tuanthanhhh/project233/image/Pulse-Oximeter-Sensor-Working-450x359.jpg

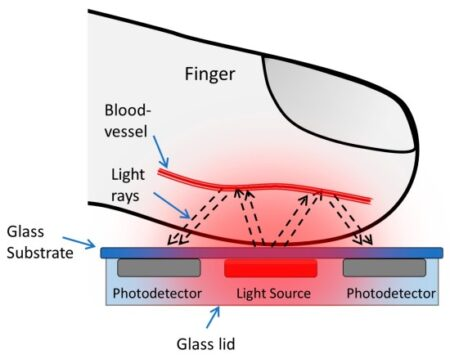
image/Pulse-Oximeter-Sensor-Working-450x359.jpg
