tuanthanhhh/project233/image/Khối chính trong hệ thống.png

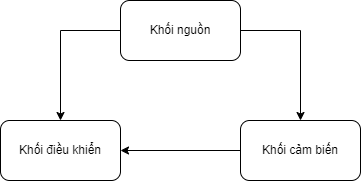
image/Khối chính trong hệ thống.png
