tuanthanhhh/project233/image/QR_github.png

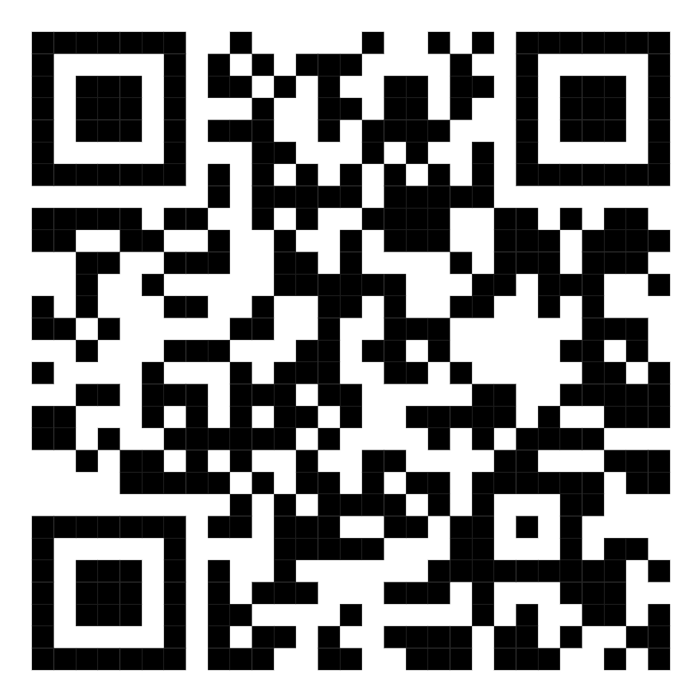
image/QR_github.png
