tuanthanhhh/project233/PCB/3D_Lib/1042.STEP

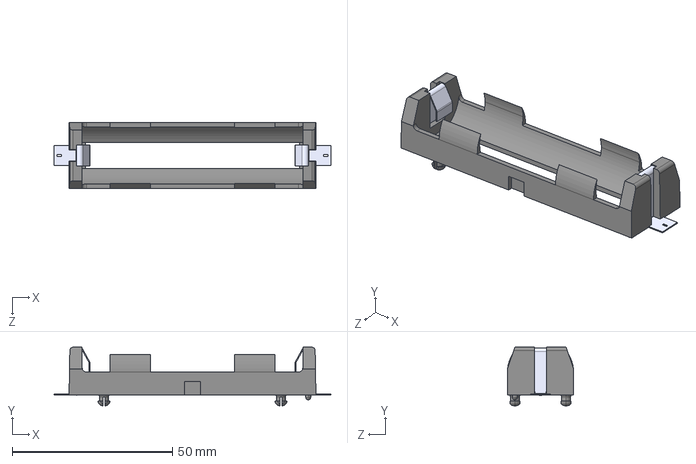
[picture p64: CAD file, 2024-06-25]
PCB/3D_Lib/1042.STEP
86.5 x 18.3 x 20.7 mm
