tuanthanhhh/project233/PCB/3D_Lib/inductor.STEP

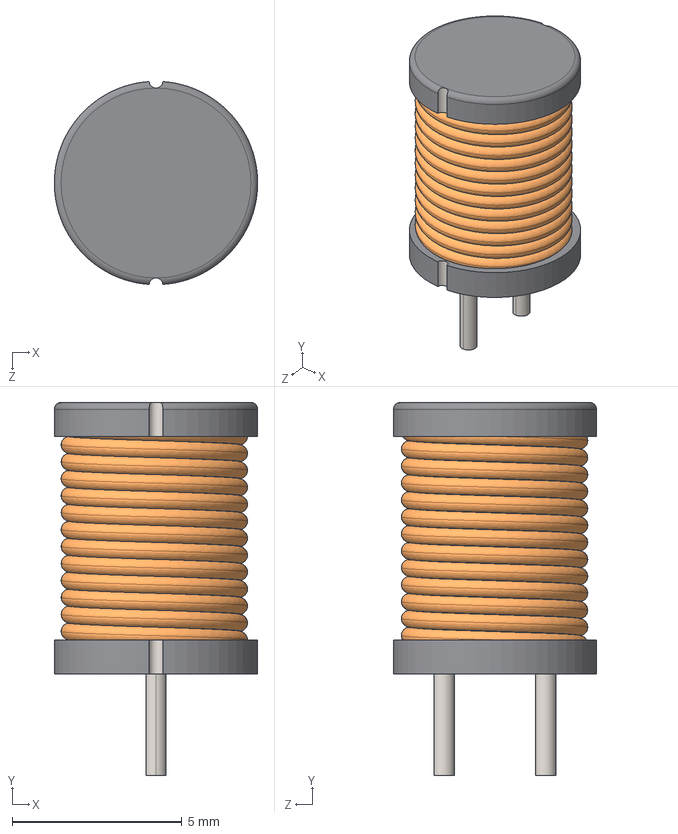
[picture p65: CAD file, 2024-06-06]
PCB/3D_Lib/inductor.STEP
6.00 x 11.0 x 5.99 mm
