tuanthanhhh/project233/PCB/3D_Lib/18650 Full.STEP

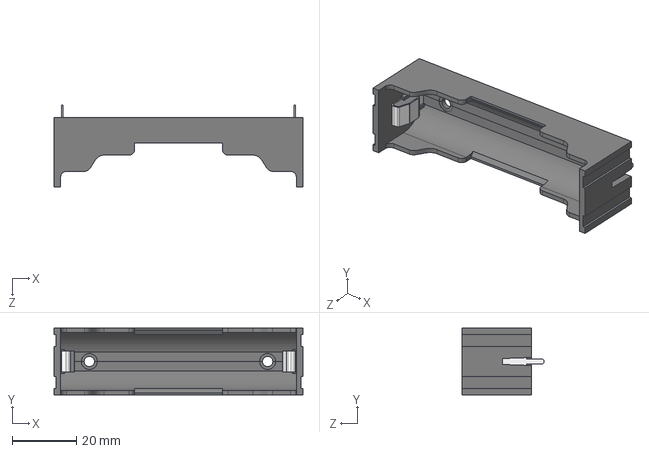
[picture p66: CAD file, 2024-06-25]
PCB/3D_Lib/18650 Full.STEP
77.6 x 20.8 x 25.5 mm
18650m_1
18650s_По умолчанию x 2
