tuanthanhhh/project233/PCB/docs schematic/STM32F1-STM32F103C8T6-Blue-Pill-schematics.pdf

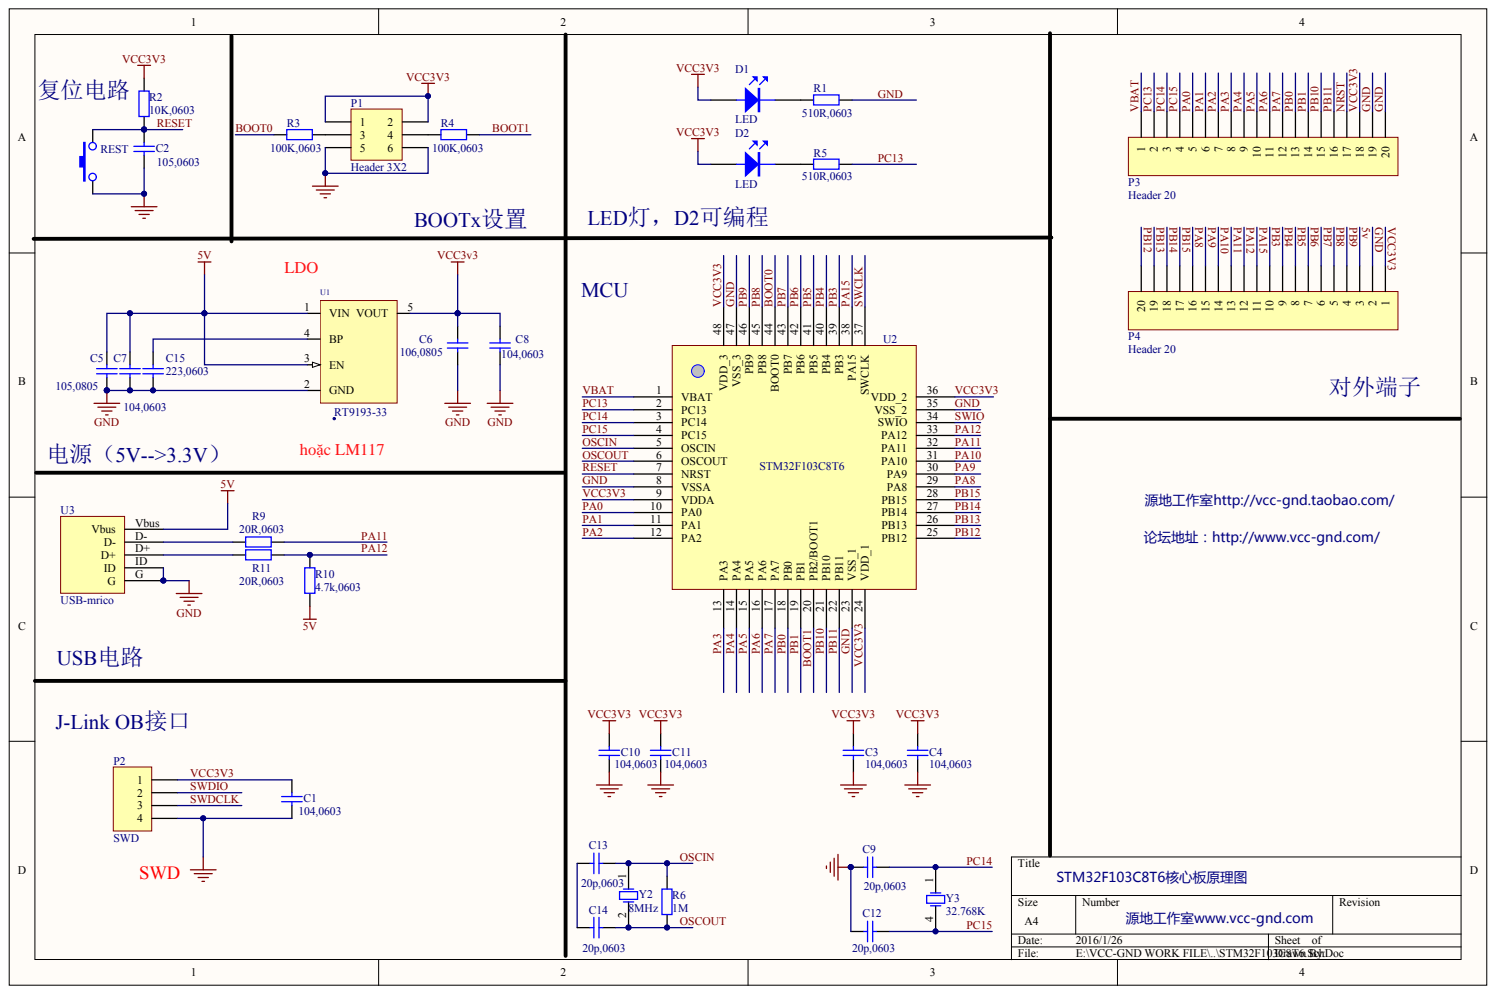
[picture p67: page 1]

源地工作室http://vcc-gnd.taobao.com/

论坛地址：http://www.vcc-gnd.com/

源地工作室www.vcc-gnd.com
