tuanthanhhh/project233/PCB/PCB_DOAN2/schematic.pdf

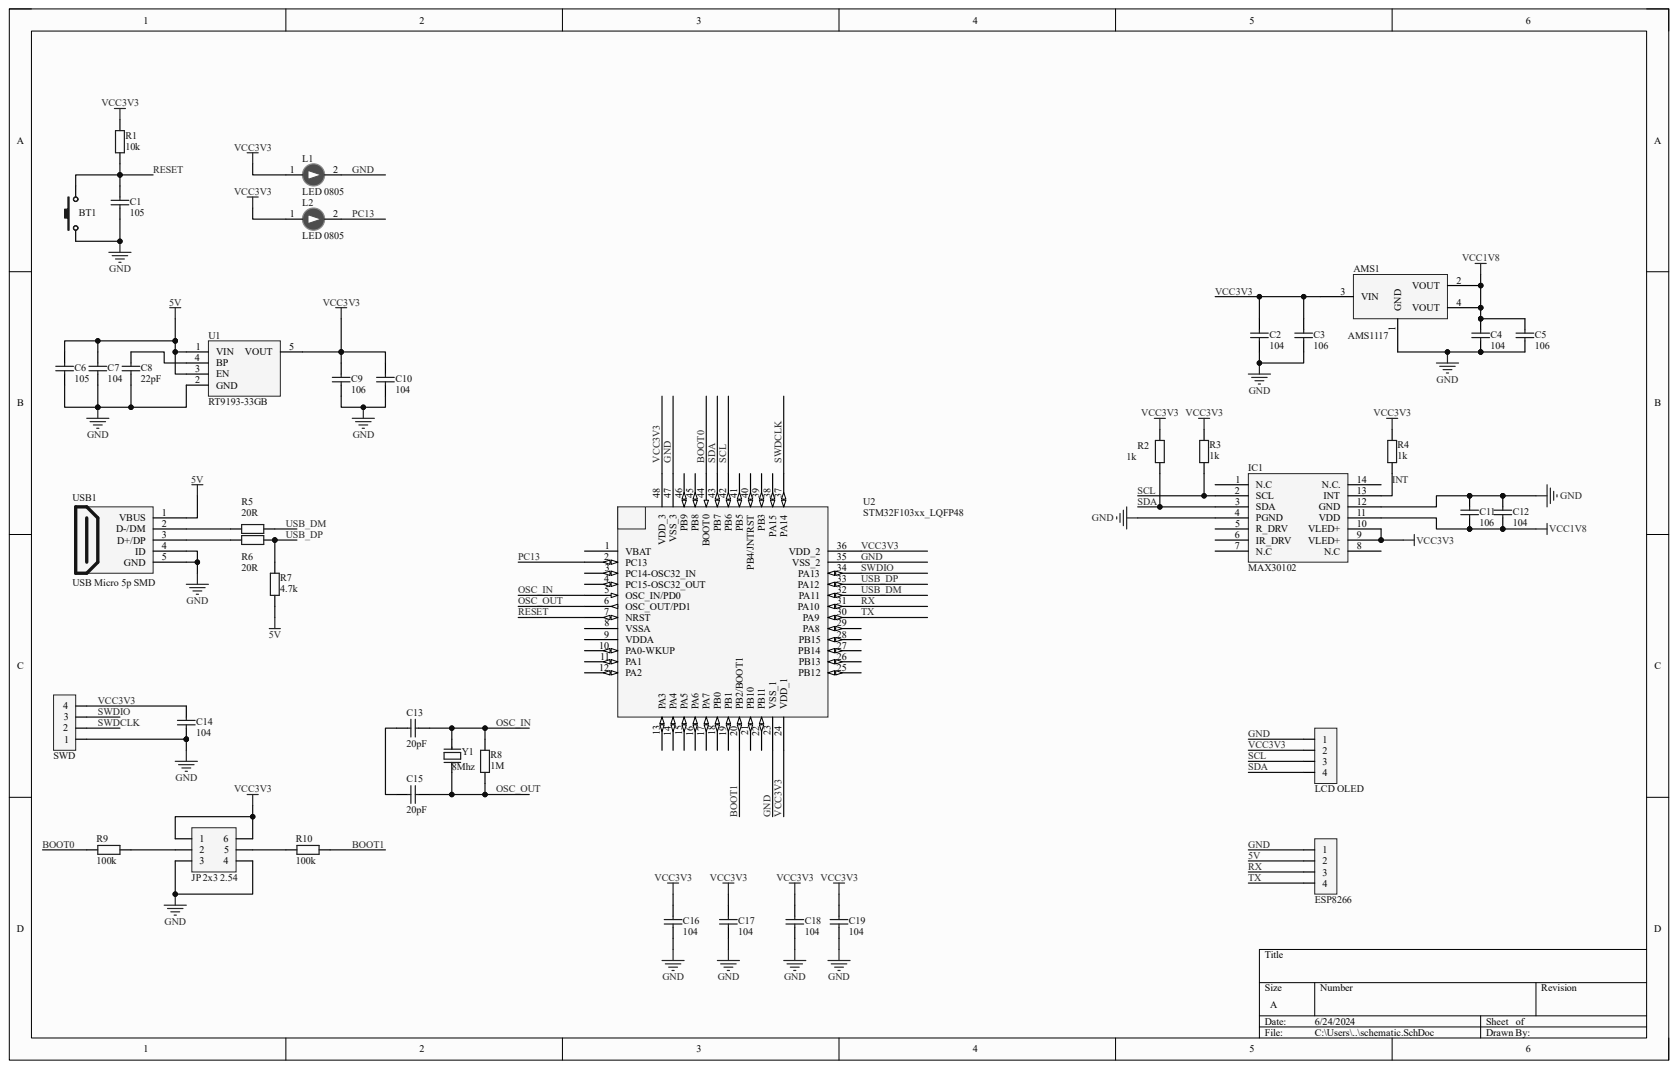
[picture p68: page 1]
