tuanthanhhh/project233/(list of files, drawings)

Other design files:
PCB/Lib_PCB/inductor.PcbLib
PCB/Lib_PCB/MyLib.PcbLib
PCB/Lib_PCB/MyLib.SchLib
PCB/PCB_DOAN2/PCB1.PcbDoc
PCB/PCB_DOAN2/PCB_DOAN2.PrjPcb
PCB/PCB_DOAN2/schematic.SchDoc
