tuanthanhhh/project233/PCB_Kicad/PCB/project233/project233.kicad_pcb

## KiCad design PCB_Kicad/PCB/project233/project233.kicad_pcb (2024-07-12)

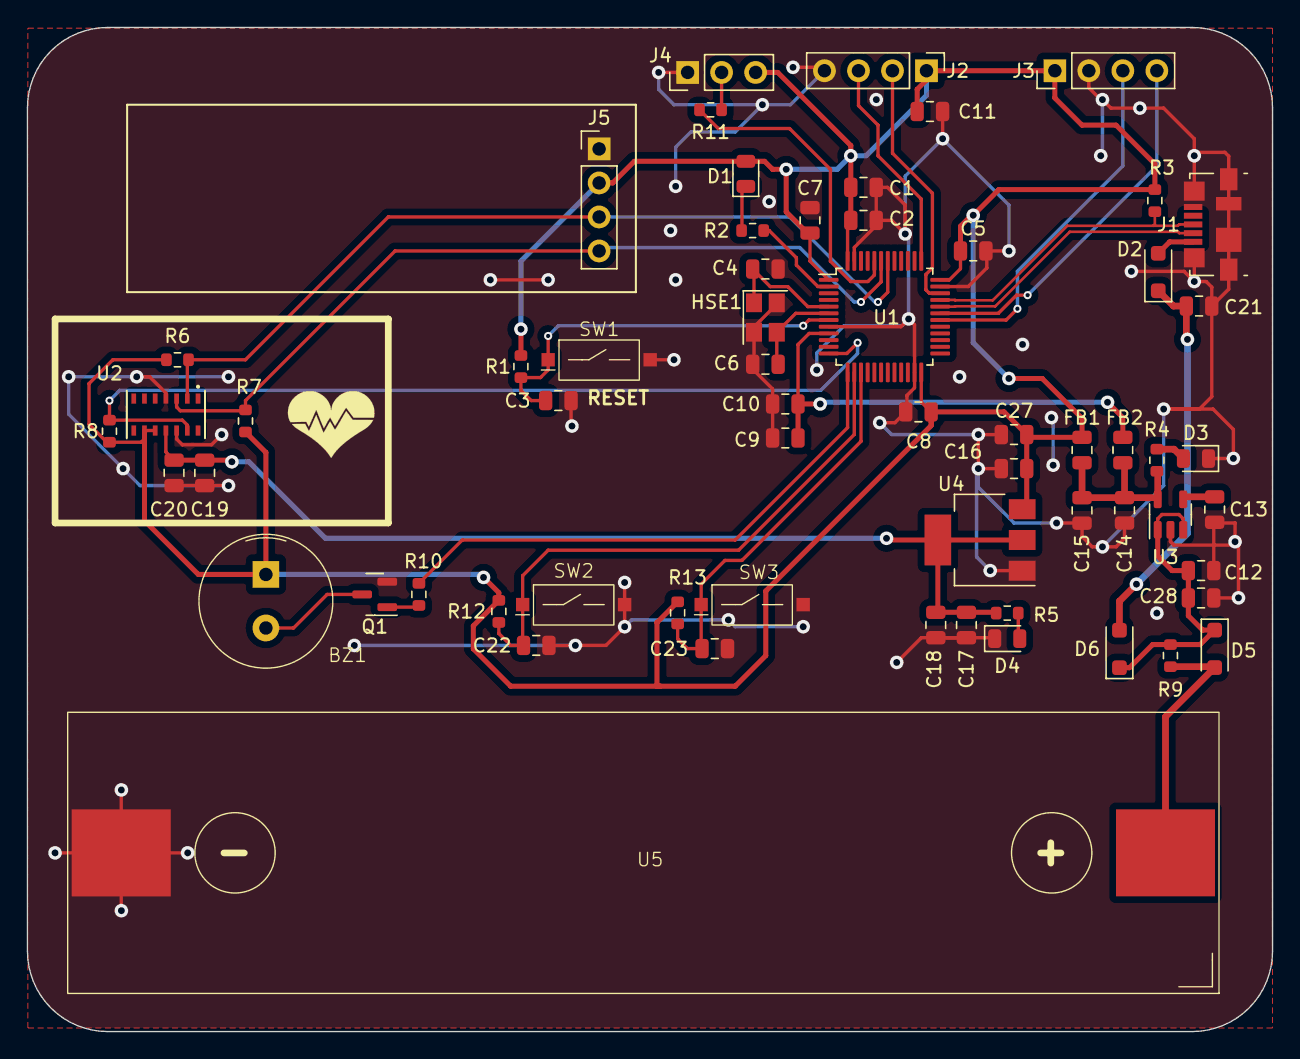
[picture p69: board project233.kicad_pcb from above]

Board: 2 copper layers, 93.0 x 75.0 mm, 62 parts (0 on the bottom side), 33 nets.

Parts:
BZ1: Buzzer; Buzzer_9056_THT
C1: 4.7uF; C_0805_2012Metric
C2, C5, C7, C8, C9, C11, C13, C15, C16, C17, C21, C22, C23, C28: 100nF; C_0805_2012Metric
C3: 4.7nF; C_0805_2012Metric
C4, C6: 15pF; C_0805_2012Metric
C10: 1uF; C_0805_2012Metric
C12: 10uF/16V; C_0805_2012Metric
C14: 22uF/16V; C_0805_2012Metric
C18, C19, C27: 10uF; C_0805_2012Metric
C20: 100n; C_0805_2012Metric
D1: RED_LED; LED_0805_2012Metric
D2: B120-E3; D_SOD-123F
D3, D4: LED; LED_0805_2012Metric
D5, D6: 1N4007; D_SOD-123F
FB1, FB2: 0805; C_0805_2012Metric
HSE1: 8MHz; Crystal_SMD_3225-4Pin_3.2x2.5mm
J1: USB_B_Micro; USB_Micro-B_Molex_47346-0001
J2, J3, J5: Header_1x4; PinHeader_1x04_P2.54mm_Vertical
J4: Header_1x3; PinHeader_1x03_P2.54mm_Vertical
Q1: 2SC1815; SOT-23
R1, R11: 10k; R_0603_1608Metric
R2, R10: 150R; R_0603_1608Metric
R3: 4k7; R_0603_1608Metric
R4, R5, R9, R12, R13: 1k; R_0603_1608Metric
R6, R7, R8: 1K; R_0603_1608Metric
SW1: RESET; Button_3x6_SMD
SW2: BT1; Button_3x6_SMD
SW3: BT2; Button_3x6_SMD
U1: STM32F103C8T6; LQFP-48_7x7mm_P0.5mm
U2: MAX30102EFD_; 21-1048_F143A5&plus_1_MXM
U3: RT9193-33GB; SOT-23-5
U4: AMS1117-1.8; SOT-223-3_TabPin2
U5: Batt_Holder; Holder_18650_SMD

Connections:
+1V8: C17.1, C18.1, C19.1, C20.1, R5.1, U2.11 (VDD), U4.2 (VO)
+5V: C21.1, D2.1 (K), D6.2 (A)
/MCU/BOOT0: R11.2, U1.44 (BOOT0)
/MCU/BT_1: C22.1, R12.2, SW2.1, U1.14 (PA4)
/MCU/BT_2: C23.1, R13.2, SW3.1, U1.15 (PA5)
/MCU/BUZZER_EN: R10.2, U1.13 (PA3)
/MCU/DEBUG_LED: R2.1, U1.2 (PC13)
/MCU/HSE_IN: C4.1, HSE1.1, U1.5 (PD0)
/MCU/HSE_OUT: C6.1, HSE1.3, U1.6 (PD1)
/MCU/NRST: C3.1, R1.1, SW1.1, U1.7 (NRST)
/MCU/RX: J3.3, U1.30 (PA9)
/MCU/SWCLK: J2.3, U1.37 (PA14)
/MCU/SWDIO: J2.2, U1.34 (PA13)
/MCU/TX: J3.4, U1.31 (PA10)
/MCU/USB+: J1.3 (D+), R3.2, U1.33 (PA12)
/MCU/USB-: J1.2 (D-), U1.32 (PA11)
GND: C1.2, C2.2, C3.2, C4.2, C5.2, C6.2, C7.2, C8.2, C9.2, C10.2, C11.2, C12.2, C13.2, C14.2, C15.2, C16.2, C17.2, C18.2, C19.2, C20.2, C21.2, C22.2, C23.2, C27.2, C28.2, D3.1 (K), D4.1 (K), HSE1.2, HSE1.4, J1.5 (GND), J1.6 (Shield), J2.4, J3.2, J4.1, J5.1, Q1.2 (E), SW1.2, SW2.2, SW3.2, U1.8 (VSSA), U1.23 (VSS), U1.35 (VSS), U1.47 (VSS), U2.4 (PGND), U2.12 (GND), U3.2 (GND), U4.1 (GND), U5.2 (-)
unnamed: BZ1.2 (+), Q1.3 (C)
unnamed: D1.1 (K), R2.2
unnamed: D2.2 (A), J1.1 (VBUS)
unnamed: D3.2 (A), R4.2
unnamed: D4.2 (A), R5.2
unnamed: D5.2 (A), R9.2, U5.1 (+)
unnamed: C12.1, C28.1, D5.1 (K), D6.1 (K), R9.1, U3.1 (VIN), U3.3 (EN)
unnamed: J4.2, R11.1
unnamed: Q1.1 (B), R10.1
unnamed: C13.1, U3.4 (BP)
unnamed: C14.1, C15.1, FB1.2, FB2.2, R4.1, U3.5 (VOUT)
SCL: J5.3, R6.2, U1.42 (PB6), U2.2 (SCL)
SDA: J5.4, R7.2, U1.43 (PB7), U2.3 (SDA)
VCC: BZ1.1 (-), C1.1, C2.1, C5.1, C7.1, C8.1, C11.1, C16.1, C27.1, D1.2 (A), FB1.1, J2.1, J3.1, J4.3, J5.2, R1.2, R3.1, R6.1, R7.1, R8.2, R12.1, R13.1, U1.1 (VBAT), U1.24 (VDD), U1.36 (VDD), U1.48 (VDD), U2.9 (VLED+), U2.10 (VLED+), U4.3 (VI)
VDDA: C9.1, C10.1, FB2.1, U1.9 (VDDA)
~INT: R8.1, U1.12 (PA2), U2.13 (~INT)
