tuanthanhhh/project233/firmware_V2/test_oled/Core/Src/main.c

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
/* Includes ------------------------------------------------------------------*/
#include "main.h"

/* USER CODE BEGIN Includes */
#include <stdio.h>
#include <bitmaps.h>
#include <fonts.h>
#include <gifs.h>
#include <ssd1306.h>
#include <max30102.h>
/* USER CODE END Includes */

I2C_HandleTypeDef hi2c1;

UART_HandleTypeDef huart1;

/* USER CODE BEGIN PV */
int __io_putchar(int ch)
{
  uint8_t temp = ch;
  HAL_UART_Transmit(&huart1, &temp, 1, HAL_MAX_DELAY);
  return ch;
}


// Override plot function



void max30102_plot(uint32_t ir_sample, uint32_t red_sample,uint32_t heart_Rate, uint32_t SpO2)
{
    // printf("ir:%u\n", ir_sample);                  // Print IR only
    // printf("r:%u\n", red_sample);                  // Print Red only
   // printf("ir:%lu,r:%lu\n", ir_sample, red_sample);    // Print IR and Red
    printf("%d,%d\n",heart_Rate,SpO2);
    //printf("heart rate:%d \n",heart_Rate);

}

max30102_t max30102;
typedef enum state {NO_FINGER,FINGER} state_t;

uint8_t heart_rate;
uint8_t SpO2_value;


/* USER CODE END PV */

void SystemClock_Config(void);
static void MX_GPIO_Init(void);
static void MX_I2C1_Init(void);
static void MX_USART1_UART_Init(void);
/**
  * @brief  The application entry point.
  * @retval int
  */
int main(void)
{
  /* MCU Configuration--------------------------------------------------------*/

  /* Reset of all peripherals, Initializes the Flash interface and the Systick. */
  HAL_Init();

  /* Configure the system clock */
  SystemClock_Config();

  /* Initialize all configured peripherals */
  MX_GPIO_Init();
  MX_I2C1_Init();
  MX_USART1_UART_Init();
  /* USER CODE BEGIN 2 */
  max30102_init(&max30102, &hi2c1);
  max30102_reset(&max30102);
  max30102_clear_fifo(&max30102);
  max30102_set_fifo_config(&max30102, max30102_smp_ave_8, 1, 7);

  // Sensor settings
  max30102_set_led_pulse_width(&max30102, max30102_pw_16_bit);
  max30102_set_adc_resolution(&max30102, max30102_adc_2048);
  max30102_set_sampling_rate(&max30102, max30102_sr_800);
  max30102_set_led_current_1(&max30102, 6.2);
  max30102_set_led_current_2(&max30102, 6.2);

  // Enter SpO2 mode
  max30102_set_mode(&max30102, max30102_spo2);
  max30102_set_a_full(&max30102, 1);

  // Initiate 1 temperature measurement
  max30102_set_die_temp_en(&max30102, 1);
  max30102_set_die_temp_rdy(&max30102, 1);

  uint8_t en_reg[2] = {0};
  max30102_read(&max30102, 0x00, en_reg, 1);
  HAL_Delay(1000);
  HAL_GPIO_WritePin(GPIOC, GPIO_PIN_13, 1);

  SSD1306_Init();
  /* USER CODE END 2 */

  /* Infinite loop */
  /* USER CODE BEGIN WHILE */
  while (1)
  {
    /* USER CODE END WHILE */

    /* USER CODE BEGIN 3 */
	    //if (max30102_has_interrupt(&max30102))
	   // {
		      max30102_interrupt_handler(&max30102);
		      heart_rate = max30102_getHeartRate();
		      SpO2_value = max30102_getSpO2();
		      max30102_plot(0, 0, heart_rate, SpO2_value);
		      SSD1306_Clear();
		      SSD1306_GotoXY(0, 0);
		      SSD1306_UpdateScreen();
		      SSD1306_Println("SpO2 = %d",SpO2_value);
		      HAL_Delay(1000);

		      //HAL_GPIO_TogglePin(GPIOC, GPIO_PIN_13);
	   // }




  }
  /* USER CODE END 3 */
}

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
