tuanthanhhh/project233/firmware_V2/test_oled/Core/Inc/main.h

#define TEST_Pin GPIO_PIN_13
#define TEST_GPIO_Port GPIOC
#define buzzer_Pin GPIO_PIN_3
#define buzzer_GPIO_Port GPIOA
#define INT_Pin GPIO_PIN_4
#define INT_GPIO_Port GPIOA
#define INT_EXTI_IRQn EXTI4_IRQn
