tuanthanhhh/project233/(commit log)

2024-06-06 create project
    [MyLib.PcbLib, MyLib.SchLib, PCB_DOAN2.PrjPcb, component.xlsx, inductor.PcbLib, inductor.STEP]
2024-06-21 update hard ware, firmware, datasheet
    [MyLib.SchLib, PCB1.PcbDoc, PCB_DOAN2.PrjPcb, component.xlsx, schematic.SchDoc]
2024-06-22 update 22/06/2024
    [PCB1.PcbDoc, schematic.SchDoc]
2024-06-24 update kicad PCB
    [MCU.kicad_sch, SENS.kicad_sch, project233.kicad_pcb, project233.kicad_sch]
2024-06-25 update PCB
    [1042.STEP, MyLib.SchLib, PCB1.PcbDoc, inductor.PcbLib, schematic.SchDoc]
2024-06-25 update 3D Lib
    [18650 Full.STEP]
2024-06-28 updated pcb
    [PCB1.PcbDoc, schematic.SchDoc]
2024-07-02 complete PCB design
    [PCB1.PcbDoc, PCB_DOAN2.PrjPcb]
2024-07-03 export gerber file
    [PCB1.PcbDoc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]
2024-07-05 export Gerber
    [project233-B_Cu.gbr, project233-B_Mask.gbr, project233-B_Paste.gbr, project233-B_Silkscreen.gbr, project233-Edge_Cuts.gbr, project233-F_Cu.gbr, project233-F_Mask.gbr, project233-F_Paste.gbr]
2024-07-05 add Gerber.rar
    [project233.kicad_pcb]
2024-07-05 add Gerber.zip
    [project233-NPTH.drl, project233-PTH.drl]
2024-07-16 fix schematic and PCB
    [PCB1.PcbDoc, schematic.SchDoc]
2024-07-16 add image files, change layout schematic and update firmware
    [schematic.SchDoc]
2024-07-18 update 18/07
    [PCB1.PcbDoc, schematic.SchDoc]
2024-08-28 add firmware_V2 and fix bug
    [main.c, main.h, max30102.c, max30102.h, test_oled.ioc]
2024-08-29 fixbug and add several function
    [main.c, max30102.c, max30102.h]
2024-09-18 add esp32 and update STM32
