tuanthanhhh/project233/(notices)

Notices in the files:
firmware_V2/test_oled/Core/Src/main.c:
Copyright (c) 2024 STMicroelectronics.
All rights reserved.
This software is licensed under terms that can be found in the LICENSE file
